sparx266/PropB3Buddy/PropB3 Documentation/PropB3_TDA.jpg

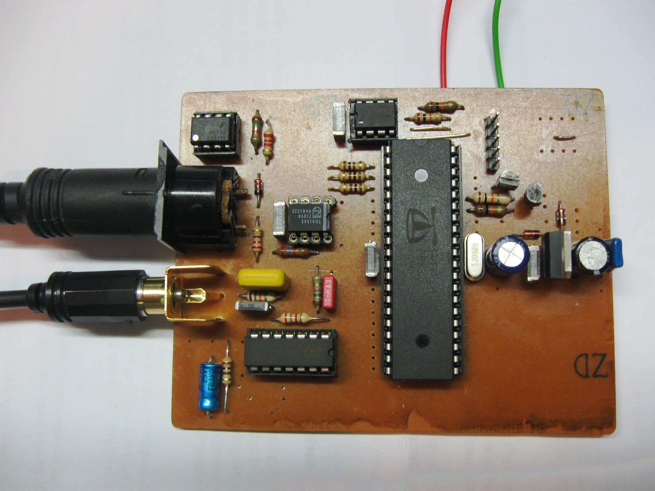
PropB3 Documentation/PropB3_TDA.jpg
