sparx266/PropB3Buddy/PropB3 Documentation/PropB3_WM.jpg

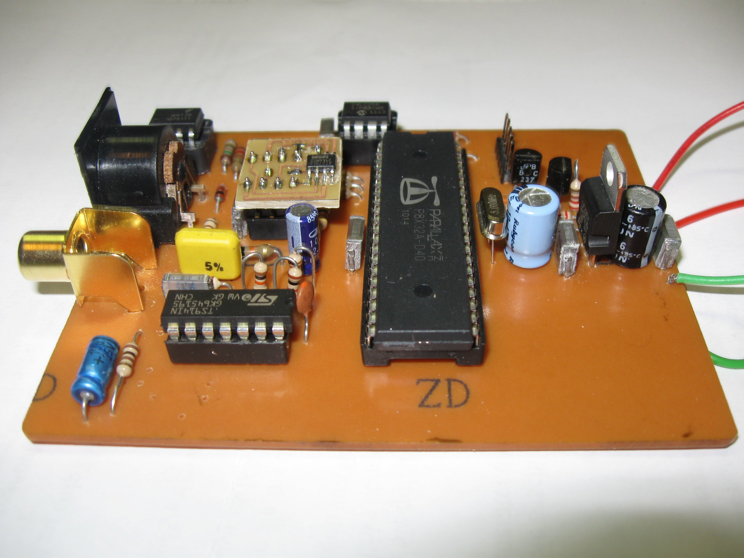
PropB3 Documentation/PropB3_WM.jpg
