sparx266/PropB3Buddy/PropB3 Documentation/PropB3_F0_TDA.pdf

## MIDI-IN

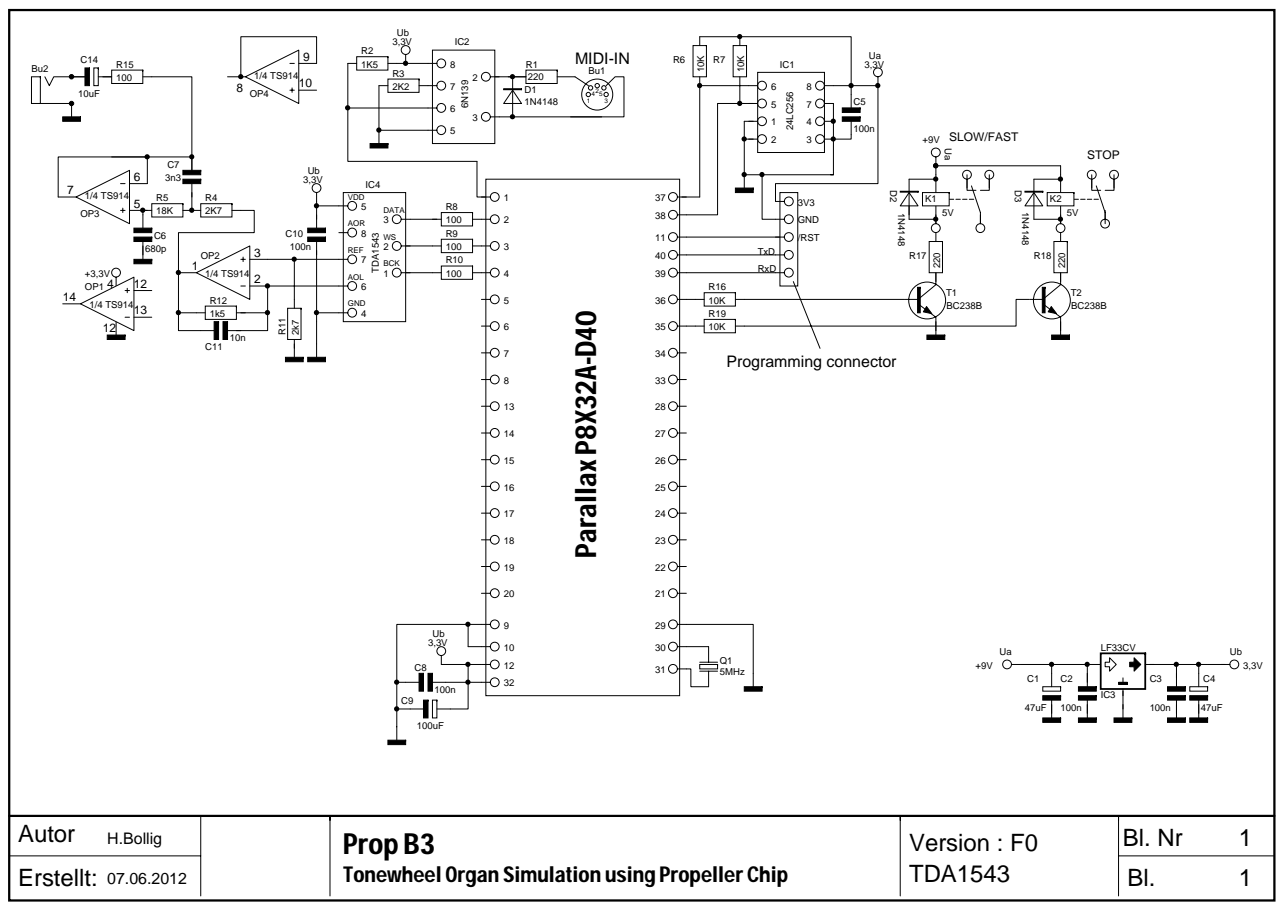
[picture p3: page 1]

Tonewheel Organ Simulation using Propeller Chip

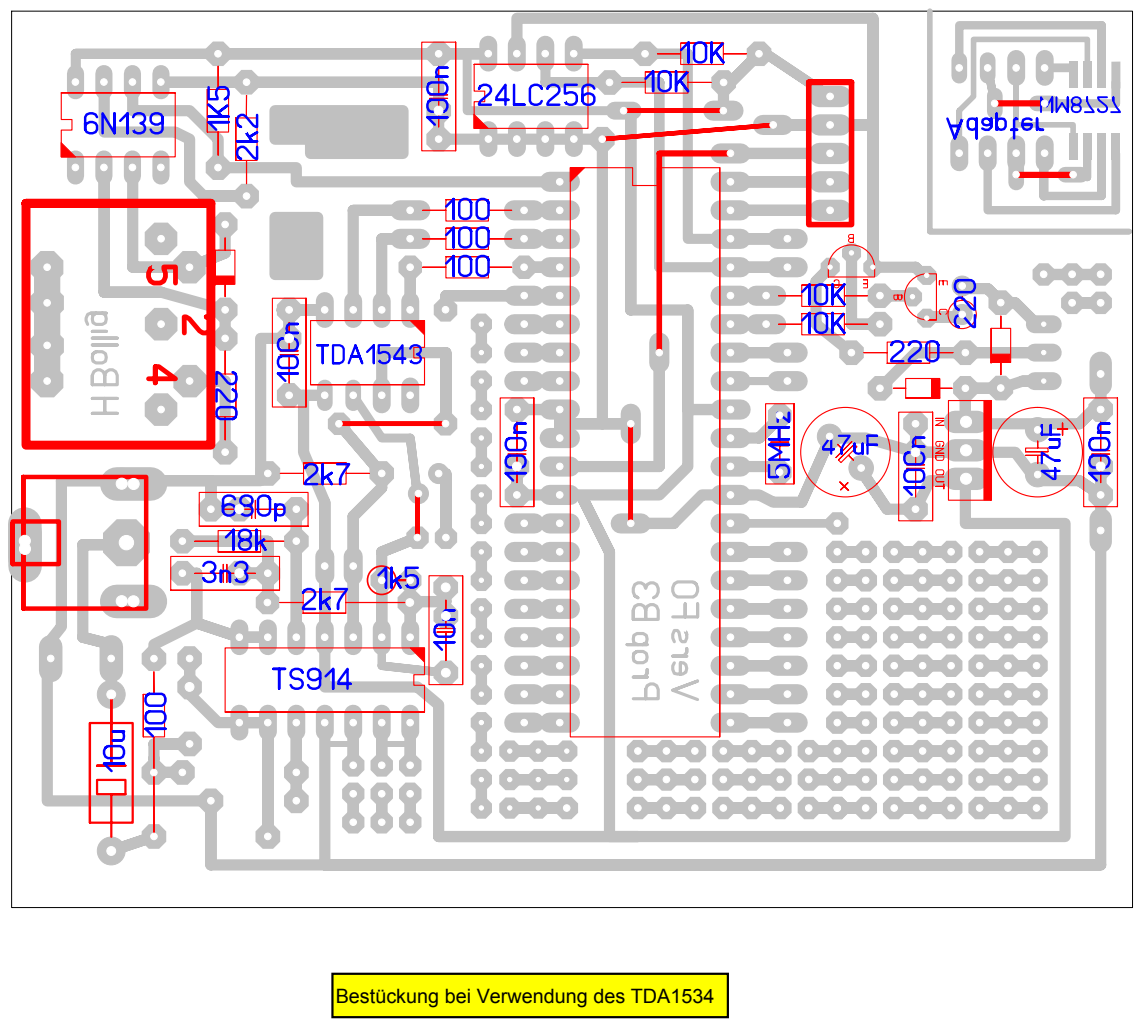
[picture p4: page 2]

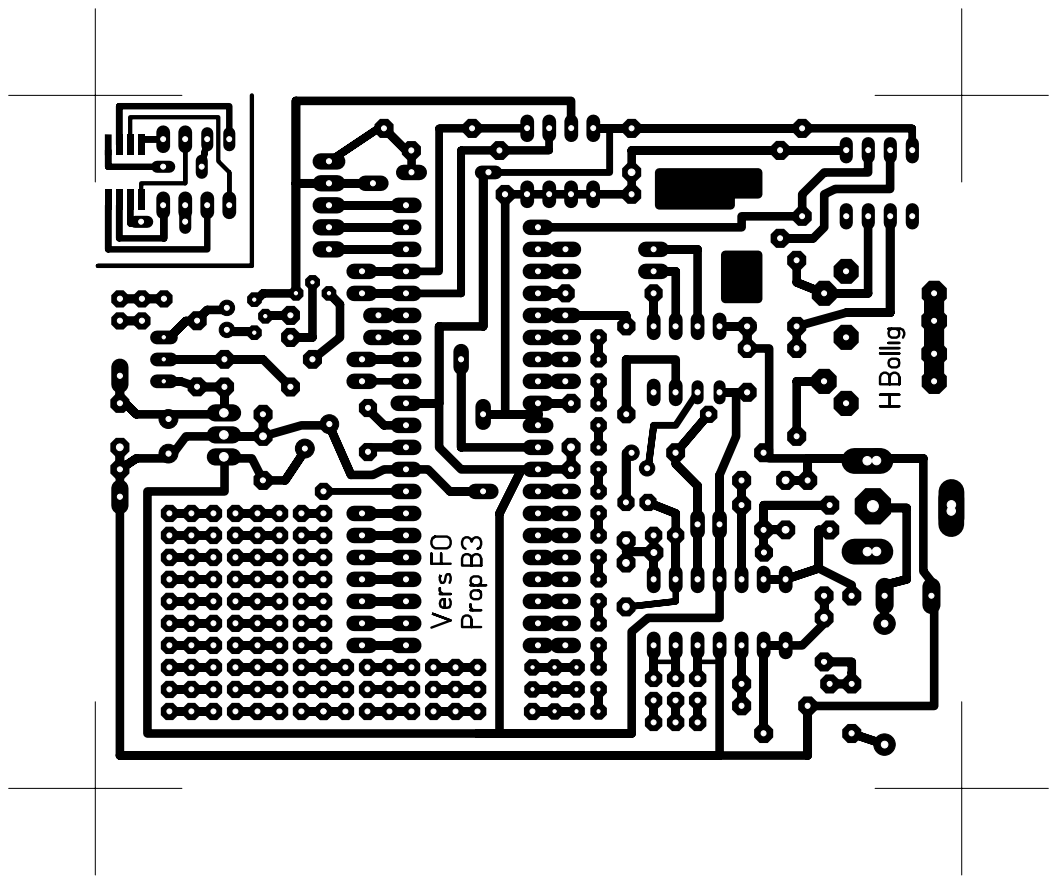
[picture p5: page 3]
