sparx266/PropB3Buddy/PropB3 Documentation/PropB3_F0_WM8727.pdf

## MIDI-IN

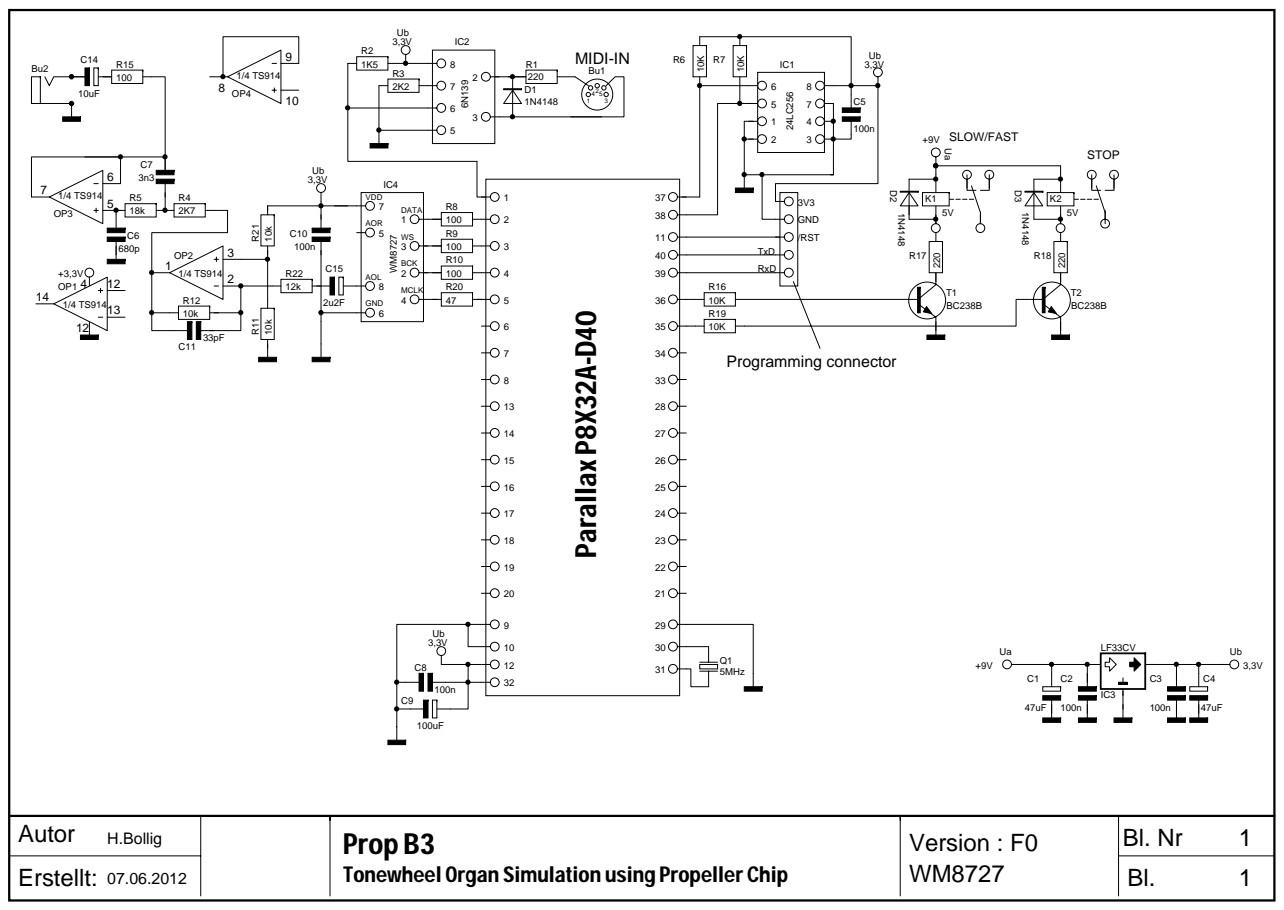
[picture p6: page 1]

Tonewheel Organ Simulation using Propeller Chip

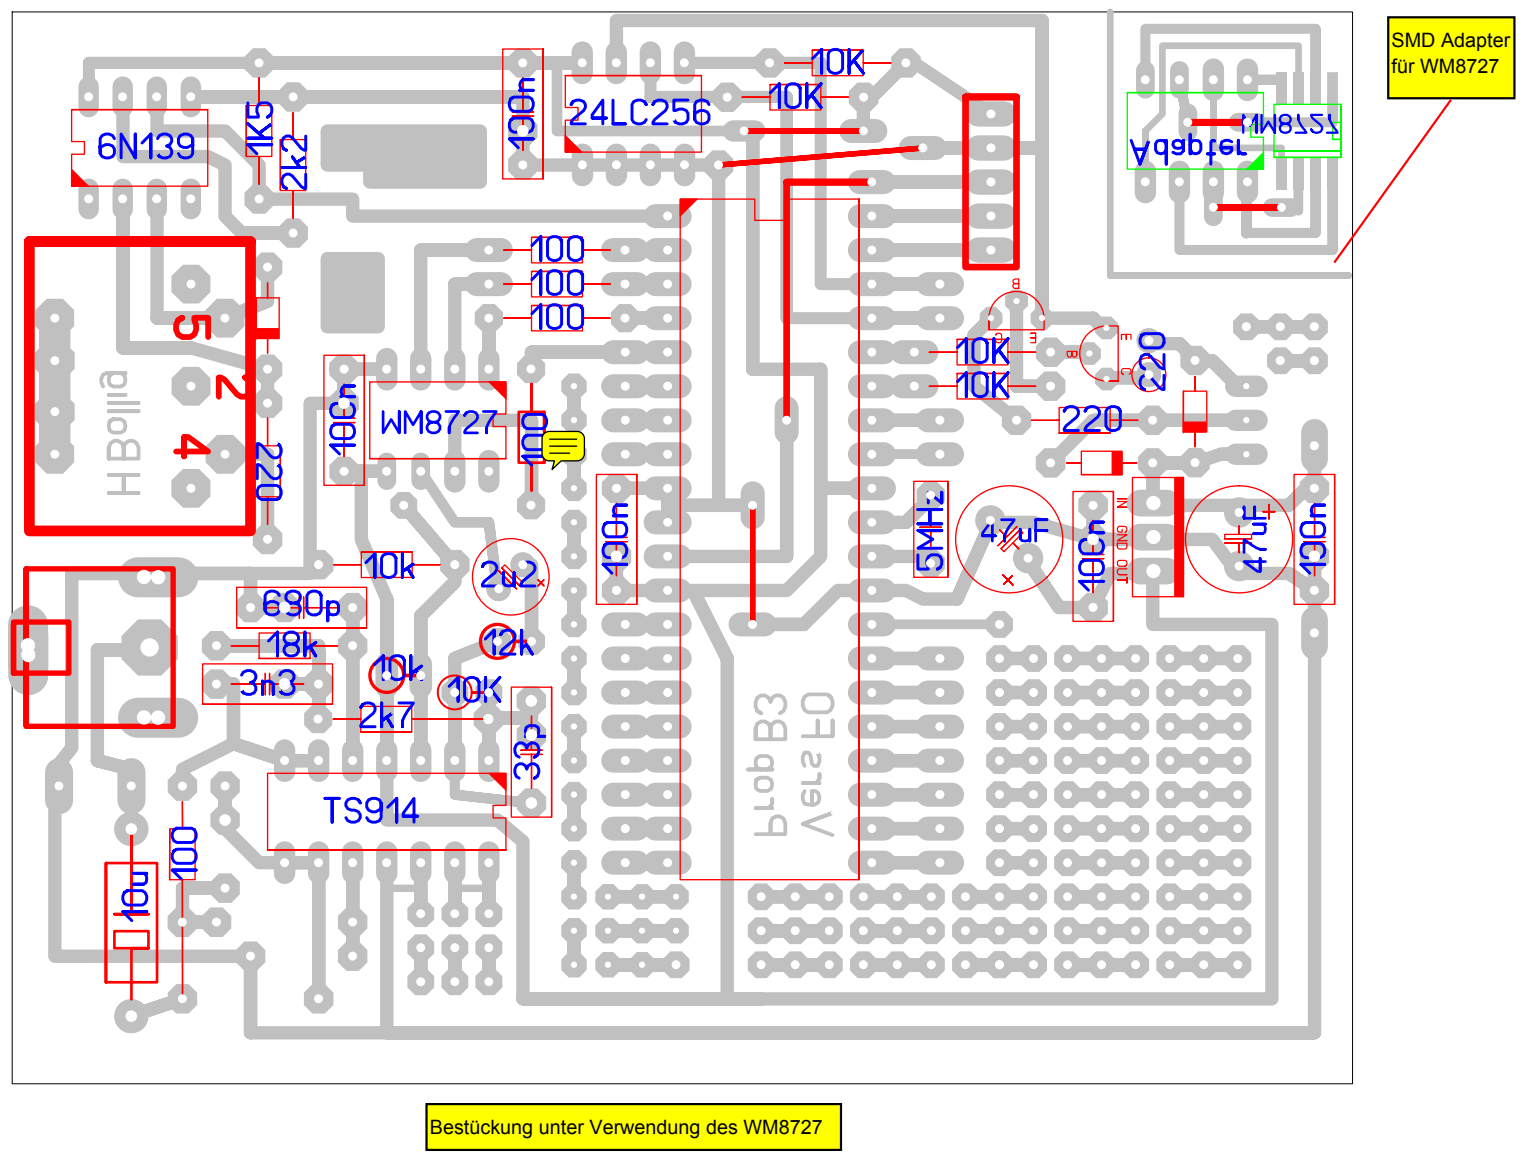
[picture p7: page 2]
