sparx266/PropB3Buddy/PropB3Buddy.pdf

A

A

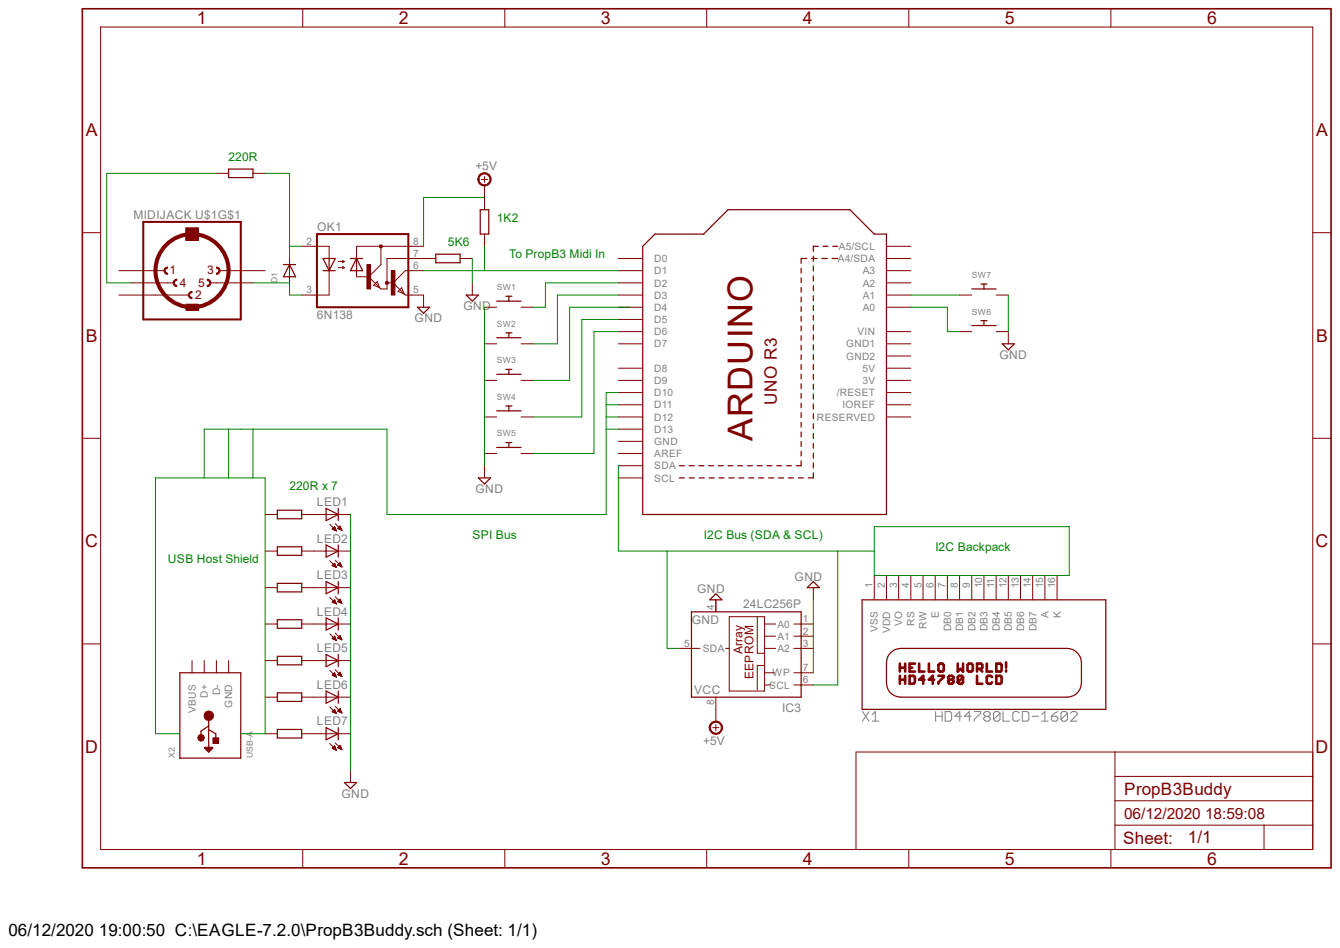
[picture p8: page 1]
