sparx266/PropB3Buddy/PropB3 Documentation/PropB3.pdf

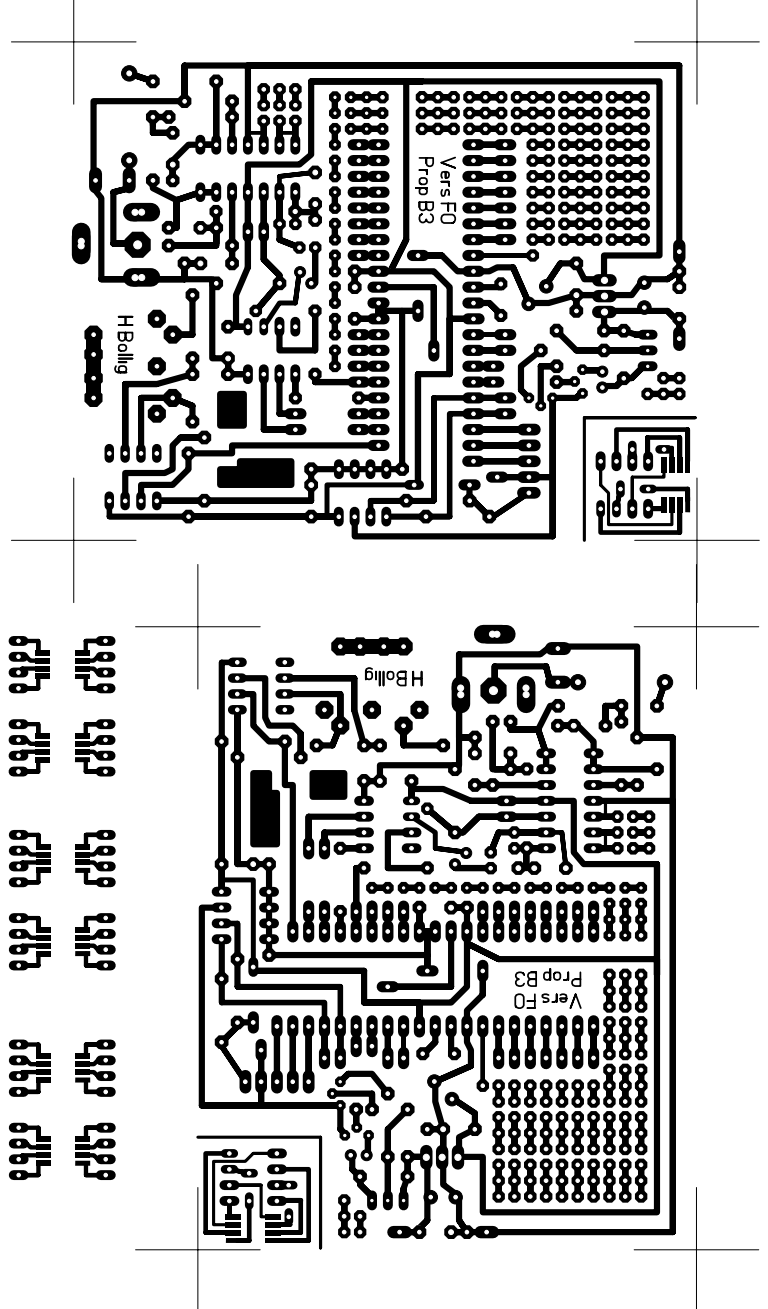
[picture p9: page 1]
