sparx266/PropB3Buddy/(commit log)

2020-12-06 Update README.md
    A project to add a controller for the PropB3 Hammond organ emulator by H Bolling.
    Arduino Uno converts USB to DIN MIDI and controller a Propeller Chip organ emulator.
2020-12-06 Update README.md
    A controller for the hammond organ clonewheel emulator running on a Propeller chip.
